giovi321/led-display/docs/src/content/docs/architecture/index.md

---
title: Architecture
description: How the firmware is put together
sidebar:
  hidden: true
---

How the firmware is put together:

- [Firmware modules](firmware/): boot order, module map, web asset pipeline, partitions
- [Pixel mapping](pixel-mapping/): the engine that turns logical coordinates into strip indices
- [Power](power/): measured consumption and the USB-C budget
