giovi321/led-display/docs/src/content/docs/index.mdx

---
title: LED Display
description: ESP32-S3 firmware for a wall display built from daisy-chained WS2812B matrix panels, with a web UI, an HTTP API, and a graphical panel arrangement editor
template: splash
hero:
  tagline: Firmware for a wall display built from daisy-chained WS2812B matrix panels and an ESP32-S3. Push one number or a short message to it over HTTP and it stays on the wall.
  actions:
    - text: Get started
      link: /led-display/getting-started/overview/
      icon: right-arrow
      variant: primary
    - text: View on GitHub
      link: https://github.com/giovi321/led-display
      icon: external
      variant: minimal
---

import { Card, CardGrid } from '@astrojs/starlight/components';
import displayRender from '../../assets/display-render.svg';

The reference build: four WS2812B 32x8 panels behind a smoked grey plexiglass front showing 1234, with a section through the layer stack

## What it does

The firmware drives a chain of WS2812B matrix panels as one logical display. It shows a single value or short message, posted to it over plain HTTP: a revenue figure, a temperature, whatever your automation sends. You describe how the panels physically hang on the wall (grid shape, chain order, rotation, wiring) in a graphical editor, and the firmware rebuilds its pixel mapping live, so changing the hardware never means recompiling.

<CardGrid stagger>
  <Card title="Set it up" icon="rocket">
    Pick the parts, build the panel sandwich, wire the level shifter, flash the firmware over USB once, and put the display on your WiFi. Start with the [overview](getting-started/overview/), then follow [hardware](getting-started/hardware/), [assembly](getting-started/assembly/), [first flash](getting-started/first-flash/), and [WiFi setup](getting-started/wifi-setup/).
  </Card>
  <Card title="Daily use" icon="setting">
    Everything routine happens in the built-in web UI: text, saved colours, brightness, three fonts at the sizes that fit, scroll modes, a weekly off or dim schedule, and the arrangement editor for the panel layout. See the [user guide](user-guide/).
  </Card>
  <Card title="Integrations" icon="puzzle">
    The device can fetch a value from a URL, or take a pushed one, and the display formats and shows it, with a fallback for feeds that break. There is also an MQTT client with Home Assistant discovery, an optional API key and web UI login, outbound webhooks, OTA updates, config backup, and a WireGuard client. See the [API reference](api-reference/).
  </Card>
</CardGrid>
