giovi321/led-display/docs/src/content/docs/development/index.md

---
title: Development
description: Building, testing, contributing, and cutting a release
sidebar:
  hidden: true
---

- [Building](building/): ESP-IDF setup, the WSL helper, host tests, web asset workflow
- [Contributing notes](contributing-notes/): repo layout, code style, what to touch when adding an endpoint
- [Releasing](releasing/): bump the version, tag, and let CI attach the binary devices update from
