giovi321/led-display/3D/8x32/Spacers.stl

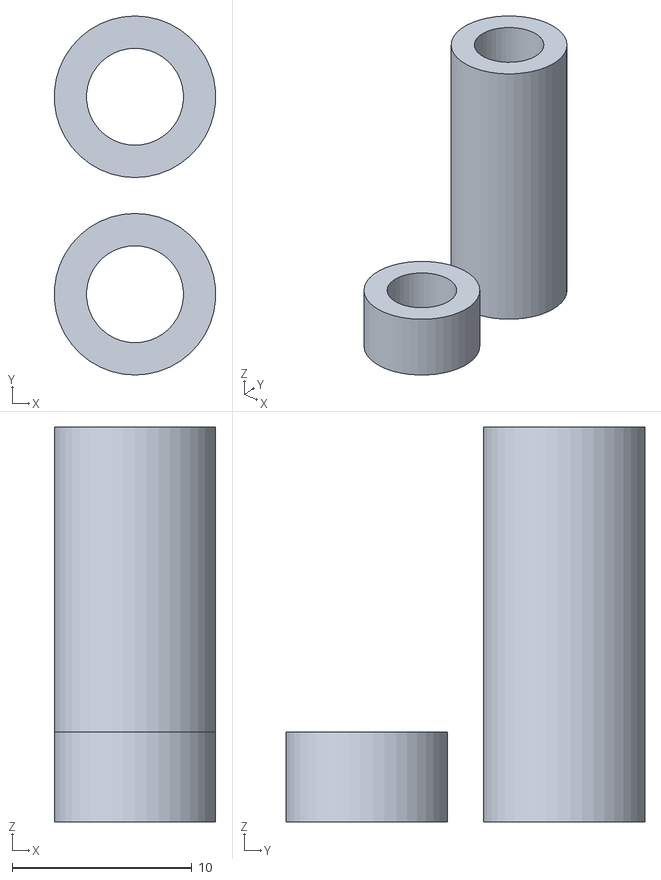
[picture p5: CAD file, 2026-08-14]
3D/8x32/Spacers.stl
8.97 x 20.0 x 22.0
