giovi321/led-display/3D/USB type c connector flange.stl

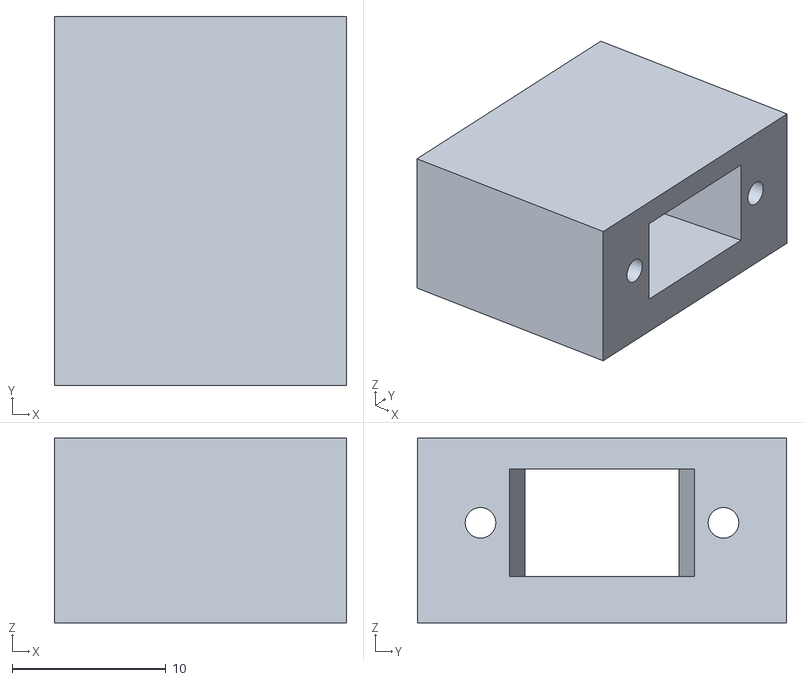
[picture p6: CAD file, 2026-08-14]
3D/USB type c connector flange.stl
19.0 x 24.0 x 12.0
