giovi321/led-display/3D/8x32/Display modules support panel.dxf

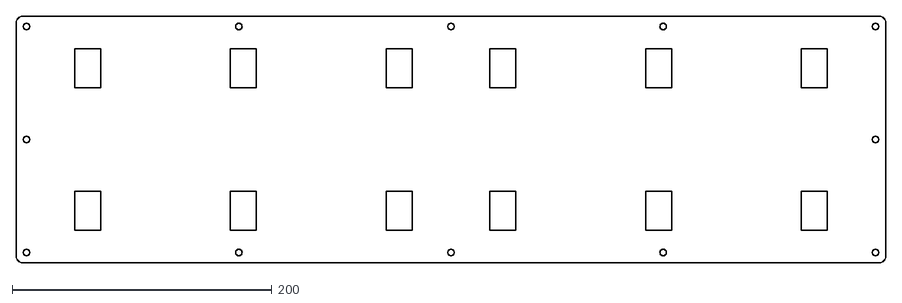
[picture p7: CAD file, 2026-08-14]
3D/8x32/Display modules support panel.dxf
670.0 x 190.0
