giovi321/led-display/3D/Box for PCB_v2.stl

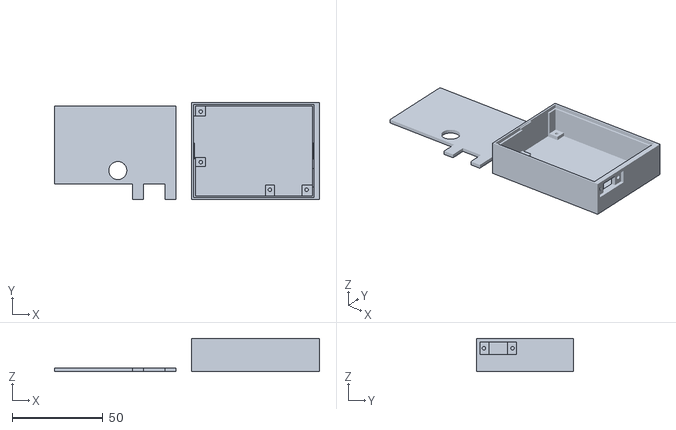
[picture p8: CAD file, 2026-08-14]
3D/Box for PCB_v2.stl
146.4 x 53.6 x 18.5
