giovi321/led-display/3D/8x32/Front and back panels.dxf

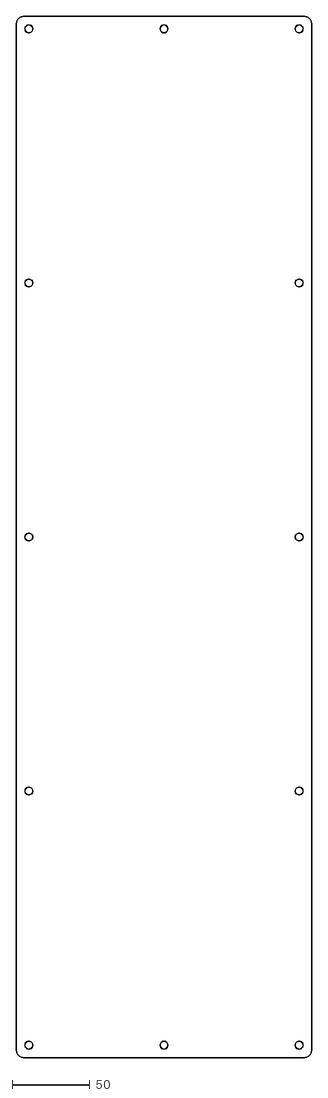
[picture p9: CAD file, 2026-08-14]
3D/8x32/Front and back panels.dxf
190.0 x 670.0
