giovi321/led-display/docs/src/content/docs/user-guide/index.md

---
title: User guide
description: "Daily use: text, colours, schedule, and value updates"
sidebar:
  hidden: true
---

The daily-use side of the web UI and API:

- [Display](display/): text, saved colours, brightness, scroll modes, fonts, size and spacing
- [Schedule](schedule/): switch the display off or dim it by weekday and time
- [Value updates](value-updates/): fetch a number from a URL or push it from n8n or any webhook source, with device-side formatting and a fallback
- [Screens](screens/): what the panel shows at power-on, once the network is up, and when the WiFi link drops
