giovi321/led-display/docs/src/content/docs/getting-started/index.md

---
title: Getting started
description: From parts to a display on your network
sidebar:
  hidden: true
---

From parts to a working display:

1. [Overview](overview/): what the firmware does and what is in the repository
2. [Hardware](hardware/): parts list, level shifter wiring, power budget
3. [Assembly](assembly/): build the reference display from the cut and printed parts
4. [First flash](first-flash/): build with ESP-IDF and flash over USB
5. [WiFi setup](wifi-setup/): join your network through the captive portal
