giovi321/led-display/(list of files, drawings)

Other design files:
PCB/RGB display_v4.fzz
