giovi321/led-display/Firmware/components/esp_wireguard/include/esp_wireguard.h

/*
 * Copyright (c) 2022 Tomoyuki Sakurai <y@trombik.org>
 * Copyright (c) 2023-2024 Simone Rossetto <simros85@gmail.com>
 * All rights reserved.
 *
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
 * 3. Neither the name of "Floorsense Ltd", "Agile Workspace Ltd" nor the names of
 *  its contributors may be used to endorse or promote products derived from this
 *   software without specific prior written permission.
 *
 * THIS SOFTWARE IS PROVIDED BY THE COPYRIGHT HOLDERS AND CONTRIBUTORS "AS IS" AND
 * ANY EXPRESS OR IMPLIED WARRANTIES, INCLUDING, BUT NOT LIMITED TO, THE IMPLIED
 * WARRANTIES OF MERCHANTABILITY AND FITNESS FOR A PARTICULAR PURPOSE ARE
 * DISCLAIMED. IN NO EVENT SHALL THE COPYRIGHT OWNER OR CONTRIBUTORS BE LIABLE FOR
 * ANY DIRECT, INDIRECT, INCIDENTAL, SPECIAL, EXEMPLARY, OR CONSEQUENTIAL DAMAGES
 * (INCLUDING, BUT NOT LIMITED TO, PROCUREMENT OF SUBSTITUTE GOODS OR SERVICES;
 * LOSS OF USE, DATA, OR PROFITS; OR BUSINESS INTERRUPTION) HOWEVER CAUSED AND ON
 * ANY THEORY OF LIABILITY, WHETHER IN CONTRACT, STRICT LIABILITY, OR TORT
 * (INCLUDING NEGLIGENCE OR OTHERWISE) ARISING IN ANY WAY OUT OF THE USE OF THIS
 * SOFTWARE, EVEN IF ADVISED OF THE POSSIBILITY OF SUCH DAMAGE.
 *
 */
#if !defined(__ESP_WIREGUARD__H__)
#define __ESP_WIREGUARD__H__

#ifdef __cplusplus
extern "C" {
#endif

/**
 * @brief Optional bring-up trace hook (local addition, see PORTING.md).
 *
 * The tunnel is brought up on the lwIP thread, so a fault inside the
 * component takes the whole device down with nothing to show for it in any
 * API. When set, this is called at each step of init/connect with the step
 * number, letting the caller record how far it got in storage that survives
 * a panic reset. NULL (the default) compiles down to nothing measurable.
 */
typedef void (*esp_wireguard_trace_fn_t)(int step);
extern esp_wireguard_trace_fn_t esp_wireguard_trace;

#define ESP_WG_TRACE(step_) \
    do { if (esp_wireguard_trace) esp_wireguard_trace(step_); } while (0)

/* Step numbers, kept here so caller and component agree. */
#define ESP_WG_STEP_CONNECT_ENTER      30
#define ESP_WG_STEP_CONNECT_NETIF      31
#define ESP_WG_STEP_CONNECT_DNS        32
#define ESP_WG_STEP_CONNECT_PEERINIT   33
#define ESP_WG_STEP_CONNECT_ADDPEER    34
#define ESP_WG_STEP_CONNECT_DONE       35
#define ESP_WG_STEP_IFINIT_ENTER       40
#define ESP_WG_STEP_IFINIT_UNDERLYING  41
#define ESP_WG_STEP_IFINIT_WGINIT      42
#define ESP_WG_STEP_IFINIT_UDP         43
#define ESP_WG_STEP_IFINIT_DEVICE      44
#define ESP_WG_STEP_IFINIT_KEYS        45
#define ESP_WG_STEP_IFINIT_DONE        46

#include <stdint.h>
#include <time.h>
#include <lwip/netif.h>
#include "esp_wireguard_err.h"

#define ESP_WIREGUARD_CONFIG_DEFAULT() { \
    .private_key = NULL, \
    .listen_port = 0, \
    .fw_mark = 0, \
    .public_key = NULL, \
    .preshared_key = NULL, \
    .address = NULL, \
    .netmask = NULL, \
    .endpoint = NULL, \
    .endpoint_ip = IPADDR4_INIT(0), \
    .port = 51820, \
    .persistent_keepalive = 0, \
}

#define ESP_WIREGUARD_CONTEXT_DEFAULT() { \
    .config = NULL, \
    .netif = NULL, \
    .netif_default = NULL, \
}

typedef struct {
    /* interface config */
    const char* private_key;            /**< a base64 private key generated by wg genkey. Required. */
    uint16_t    listen_port;            /**< a 16-bit port for listening */
    uint32_t    fw_mark;                /**< a 32-bit fwmark for outgoing packets */
    /* peer config */
    const char* public_key;             /**< a base64 public key calculated by wg pubkey from a private key. Required. */
    const char* preshared_key;          /**< a base64 preshared key generated by wg genpsk. */
    const char* address;                /**< a local IP address. */
    const char* netmask;                /**< a subnet mask of the local IP address. */
    const char* endpoint;               /**< an endpoint IP address or hostname. */
    ip_addr_t   endpoint_ip;            /**< endpoint IP address (internal use, resolved through dns query) */
    uint16_t    port;                   /**< a port number of remote endpoint. Default is 51820. */
    uint16_t    persistent_keepalive;   /**< a seconds interval, between 1 and 65535 inclusive, of how often to send an
                                             authenticated empty packet to the peer for the purpose of keeping a stateful
                                             firewall or NAT mapping valid persistently. Set zero to disable the feature.
                                             Default is zero. */
} wireguard_config_t;

typedef struct {
    wireguard_config_t* config;        /**< a pointer to wireguard config */
    struct netif*       netif;         /**< a pointer to configured netif */
    struct netif*       netif_default; /**< a pointer to the default netif. */
} wireguard_ctx_t;

/**
 * @brief Initialize WireGuard
 *
 * Call this function to initialize the context of WireGuard.
 *
 * Do not call this function multiple times.
 *
 * To connect to other peer, use `esp_wireguard_disconnect()`, and
 * `esp_wireguard_init()` with a new configuration. To reconnect to
 * the same peer just use `esp_wireguard_disconnect()` and then
 * `esp_wireguard_connect()`.
 *
 * @param       config WireGuard configuration.
 * @param[out]  ctx Context of WireGuard.
 *
 * @return
 *      - ESP_OK: Successfully initilized WireGuard interface.
 *      - ESP_ERR_INVALID_ARG: given argument is invalid.
 *      - ESP_ERR_INVALID_STATE: hostname dns resolution cannot start
 *      - ESP_FAIL: Other error.
 */
/**
 * @brief Derive the base64 public key from a base64 private key (local
 *        addition, see PORTING.md).
 *
 * Needed to configure the peer at the other end; the device has no other way
 * to report which key it is presenting. `out` needs room for 45 bytes.
 */
esp_err_t esp_wireguard_public_key(const char *private_key_b64, char *out, size_t outsz);

esp_err_t esp_wireguard_init(wireguard_config_t *config, wireguard_ctx_t *ctx);

/**
 * @brief Create a WireGuard interface and start establishing the connection
 *        to the peer.
 *
 * Call this function to start establishing the connection. Note that `ESP_OK`
 * does not mean the connection is established. To see if the connection is
 * established, or the peer is up, use `esp_wireguard_peer_is_up()`.
 *
 * Do not call this function multiple times.
 *
 * @param ctx Context of WireGuard.
 * @return
 *      - ESP_OK on success.
 *      - ESP_ERR_INVALID_ARG if input arguments are invalid
 *      - ESP_ERR_RETRY dns query still ongoing for endpoint hostname resolution (retry connection)
 *      - ESP_ERR_INVALID_IP if endpoint IP address is missing or invalid (dns query failed)
 *      - ESP_FAIL on failure.
 */
esp_err_t esp_wireguard_connect(wireguard_ctx_t *ctx);

/**
 * @brief Set the WireGuard network interface as the default.
 * @param ctx Context of WireGuard
 * @return
 *      - ESP_OK on success.
 *      - ESP_ERR_INVALID_ARG if ctx is NULL
 *      - ESP_ERR_INVALID_STATE if WireGuard interface is NULL
 */
esp_err_t esp_wireguard_set_default(const wireguard_ctx_t *ctx);

/**
 * @brief Restore the default network interface.
 * @param ctx Context of WireGuard
 * @return
 *      - ESP_OK on success.
 *      - ESP_ERR_INVALID_ARG if ctx is NULL
 *      - ESP_ERR_INVALID_STATE if the previous default interface is NULL
 */
esp_err_t esp_wireguard_restore_default(const wireguard_ctx_t *ctx);

/**
 * @brief Test if the peer is up.
 * @param ctx Context of WireGuard
 * @return
 *      - ESP_OK on peer up.
 *      - ESP_ERR_INVALID_ARG if ctx is NULL.
 *      - ESP_FAIL on peer still down.
 */
esp_err_t esp_wireguard_peer_is_up(const wireguard_ctx_t *ctx);
#define esp_wireguardif_peer_is_up(ctx) esp_wireguard_peer_is_up(ctx)  /**< backward compatibility with esp_wireguard before v0.4 */

/**
 * @brief Get timestamp of the latest handshake (with seconds resolution since unix epoch)
 * @param ctx Context of WireGuard
 * @param result the output timestamp
 * @return
 *      - ESP_OK on success
 *      - ESP_FAIL if no handshake already completed
 *      - ESP_ERR_INVALID_ARG if ctx is NULL
 *      - ESP_ERR_INVALID_STATE if data inside ctx is not valid
 */
esp_err_t esp_wireguard_latest_handshake(const wireguard_ctx_t *ctx, time_t *result);

/**
 * @brief Add new allowed IP/mask to the list of allowed ip/mask
 * @param ctx Context of WireGuard
 * @param allowed_ip The new IP to be allowed through tunnel
 * @param allowed_ip_mask The mask of the new IP
 * @return
 *      - ESP_OK on success
 *      - ESP_FAIL if the adding failed
 *      - ESP_ERR_INVALID_ARG if ctx, allowed_ip or allowed_ip_mask are invalid or empty
 *      - ESP_ERR_INVALID_STATE if data inside ctx is not valid
 */
esp_err_t esp_wireguard_add_allowed_ip(const wireguard_ctx_t *ctx, const char *allowed_ip, const char *allowed_ip_mask);

/**
 * @brief Disconnect from the peer
 *
 * @param ctx Context of WireGuard.
 * @return
 *      - ESP_OK on success.
 */
esp_err_t esp_wireguard_disconnect(wireguard_ctx_t *ctx);

#ifdef __cplusplus
}
#endif

#endif
// vim: expandtab tabstop=4
