giovi321/led-display/Firmware/main/api_colors.c

// /api/colors, /api/value and /api/value/config (see api_handlers.h for the
// ownership table, DESIGN.md section 5 for shapes).
//
// Saved colours are stored as one JSON blob ("colors" key,
// {"v":1,"colors":[{"name":"amber","r":80,"g":32,"b":0},...]}): POST
// replaces the whole list so the web UI never has to diff. /api/value is
// the generic inbound endpoint: whatever posts a number here (a webhook
// source, a home-automation flow, curl) gets it formatted through the
// value config and shown in the display's current colour, scrolling mode
// and speed.

#include <stdio.h>
#include <stdlib.h>
#include <string.h>

#include "cJSON.h"
#include "esp_log.h"

#include "api_handlers.h"
#include "display.h"
#include "integrations.h"
#include "settings.h"
#include "value_feed.h"
#include "valuefmt.h"
#include "web_common.h"

static const char *TAG = "api_colors";

#define COLORS_BLOB_KEY  "colors"
#define COLORS_MAX       12
#define COLOR_NAME_MAX   24

// ---- /api/colors -----------------------------------------------------------

static esp_err_t colors_get(httpd_req_t *req)
{
    cJSON *arr = NULL;

    char *buf = malloc(SETTINGS_BLOB_MAX);
    if (buf && settings_load_blob(COLORS_BLOB_KEY, buf, SETTINGS_BLOB_MAX,
                                  NULL) == ESP_OK) {
        cJSON *blob = cJSON_Parse(buf);
        if (blob) {
            cJSON *colors = cJSON_DetachItemFromObject(blob, "colors");
            if (cJSON_IsArray(colors)) {
                arr = colors;
            } else {
                cJSON_Delete(colors);
            }
            cJSON_Delete(blob);
        }
    }
    free(buf);

    cJSON *resp = cJSON_CreateObject();
    cJSON_AddItemToObject(resp, "colors", arr ? arr : cJSON_CreateArray());
    return web_send_json(req, resp);
}

// Validate a client-supplied colour list and rebuild it as the canonical
// blob (dropping any extra fields). Returns NULL when invalid.
static cJSON *colors_canonical(const cJSON *colors)
{
    if (!cJSON_IsArray(colors)) return NULL;
    if (cJSON_GetArraySize(colors) > COLORS_MAX) return NULL;

    cJSON *out = cJSON_CreateArray();
    const cJSON *it;
    cJSON_ArrayForEach(it, colors) {
        const cJSON *name = cJSON_GetObjectItem(it, "name");
        const cJSON *r    = cJSON_GetObjectItem(it, "r");
        const cJSON *g    = cJSON_GetObjectItem(it, "g");
        const cJSON *b    = cJSON_GetObjectItem(it, "b");
        if (!cJSON_IsString(name) || name->valuestring[0] == '\0' ||
            strlen(name->valuestring) > COLOR_NAME_MAX ||
            !cJSON_IsNumber(r) || r->valueint < 0 || r->valueint > 255 ||
            !cJSON_IsNumber(g) || g->valueint < 0 || g->valueint > 255 ||
            !cJSON_IsNumber(b) || b->valueint < 0 || b->valueint > 255) {
            cJSON_Delete(out);
            return NULL;
        }
        cJSON *entry = cJSON_CreateObject();
        cJSON_AddStringToObject(entry, "name", name->valuestring);
        cJSON_AddNumberToObject(entry, "r", r->valueint);
        cJSON_AddNumberToObject(entry, "g", g->valueint);
        cJSON_AddNumberToObject(entry, "b", b->valueint);
        cJSON_AddItemToArray(out, entry);
    }
    return out;
}

static esp_err_t colors_post(httpd_req_t *req)
{
    if (web_require_auth(req) != ESP_OK) return ESP_OK;

    cJSON *body = web_read_json(req, SETTINGS_BLOB_MAX);
    if (!body) return web_send_err(req, "invalid JSON body", 400);

    cJSON *canonical = colors_canonical(cJSON_GetObjectItem(body, "colors"));
    cJSON_Delete(body);
    if (!canonical) {
        return web_send_err(req,
                            "colors must be <=12 entries of "
                            "{name<=24ch,r,g,b 0..255}", 400);
    }

    cJSON *blob = cJSON_CreateObject();
    cJSON_AddNumberToObject(blob, "v", 1);
    cJSON_AddItemToObject(blob, "colors", canonical);
    char *json = cJSON_PrintUnformatted(blob);
    cJSON_Delete(blob);
    if (!json) return web_send_err(req, "out of memory", 500);

    esp_err_t err = settings_save_blob(COLORS_BLOB_KEY, json);
    cJSON_free(json);
    if (err != ESP_OK) {
        ESP_LOGE(TAG, "saving colors blob failed: %s", esp_err_to_name(err));
        return web_send_err(req, "saving colors failed", 500);
    }
    return web_send_ok(req);
}

// ---- /api/value ------------------------------------------------------------

static esp_err_t value_post(httpd_req_t *req)
{
    if (web_require_auth(req) != ESP_OK) return ESP_OK;

    cJSON *body = web_read_json(req, 512);
    if (!body) return web_send_err(req, "invalid JSON body", 400);

    const cJSON *val = cJSON_GetObjectItem(body, "value");
    char raw[DISPLAY_TEXT_MAX];
    if (cJSON_IsNumber(val)) {
        // Normalise JSON numbers so 4.2 and "4.2" behave the same; %.15g
        // keeps 15 significant digits without trailing-zero noise.
        snprintf(raw, sizeof(raw), "%.15g", val->valuedouble);
    } else if (cJSON_IsString(val)) {
        snprintf(raw, sizeof(raw), "%s", val->valuestring);
    } else {
        cJSON_Delete(body);
        return web_send_err(req, "body must be {\"value\":<string|number>}", 400);
    }
    cJSON_Delete(body);

    // Formats, remembers, counts as fresh and clears the fallback whatever
    // the display source; renders only while the source is "integration".
    char text[DISPLAY_TEXT_MAX];
    value_feed_ingest(raw, VALUE_SRC_HTTP, text, sizeof(text));

    settings_t cfg;
    settings_load(&cfg);
    bool rendered = (cfg.source == DISPLAY_SRC_INTEGRATION);

    cJSON *resp = cJSON_CreateObject();
    cJSON_AddBoolToObject(resp, "ok", true);
    cJSON_AddStringToObject(resp, "displayed", text);
    cJSON_AddBoolToObject(resp, "rendered", rendered);
    return web_send_json(req, resp);
}

// ---- /api/value/config -----------------------------------------------------

static esp_err_t value_cfg_get(httpd_req_t *req)
{
    value_cfg_t v;
    integrations_get_value_cfg(&v);

    // Every current key, plus the pre-2.12 stale_* / default_text keys
    // derived from the fallback config so old scripts still read something.
    cJSON *r = cJSON_CreateObject();
    integrations_value_cfg_to_json(&v, r, true);
    return web_send_json(req, r);
}

static esp_err_t value_cfg_post(httpd_req_t *req)
{
    if (web_require_auth(req) != ESP_OK) return ESP_OK;

    cJSON *body = web_read_json(req, 2048);
    if (!body) return web_send_err(req, "invalid JSON body", 400);

    // Overlay present fields onto the current config so clients can PATCH
    // a single field without knowing the whole schema.
    value_cfg_t v;
    integrations_get_value_cfg(&v);
    const char *msg = NULL;
    bool ok = integrations_value_cfg_from_json(&v, body, true, &msg);
    cJSON_Delete(body);
    if (!ok) return web_send_err(req, msg ? msg : "invalid value config", 400);

    esp_err_t err = integrations_set_value_cfg(&v);
    if (err != ESP_OK) {
        ESP_LOGE(TAG, "saving value config failed: %s", esp_err_to_name(err));
        return web_send_err(req, "saving value config failed", 500);
    }
    // A changed fallback text or mode shows now, not at the next tick.
    value_feed_apply_panel();
    return web_send_ok(req);
}

// ---- /api/value/preview ----------------------------------------------------

// Dry run of the formatter: formats `raw` with the stored config overlaid by
// the optional `cfg` object (same keys and errors as the config POST).
// Nothing is displayed or stored.
static esp_err_t value_preview_post(httpd_req_t *req)
{
    if (web_require_auth(req) != ESP_OK) return ESP_OK;

    cJSON *body = web_read_json(req, 2048);
    if (!body) return web_send_err(req, "invalid JSON body", 400);

    const cJSON *rawj = cJSON_GetObjectItem(body, "raw");
    char raw[DISPLAY_TEXT_MAX];
    if (cJSON_IsNumber(rawj)) {
        // Same normalisation as /api/value.
        snprintf(raw, sizeof(raw), "%.15g", rawj->valuedouble);
    } else if (cJSON_IsString(rawj)) {
        snprintf(raw, sizeof(raw), "%s", rawj->valuestring);
    } else {
        cJSON_Delete(body);
        return web_send_err(req,
                            "body must be {\"raw\":<string|number>,\"cfg\":{...}}",
                            400);
    }

    value_cfg_t v;
    integrations_get_value_cfg(&v);
    const cJSON *cfg = cJSON_GetObjectItem(body, "cfg");
    if (cfg && !cJSON_IsNull(cfg)) {
        const char *msg = NULL;
        if (!integrations_value_cfg_from_json(&v, cfg, true, &msg)) {
            cJSON_Delete(body);
            return web_send_err(req, msg ? msg : "invalid value config", 400);
        }
    }
    cJSON_Delete(body);

    char text[DISPLAY_TEXT_MAX];
    valuefmt_format(&v, raw, text, sizeof(text));

    cJSON *resp = cJSON_CreateObject();
    cJSON_AddStringToObject(resp, "text", text);
    return web_send_json(req, resp);
}

// ---- registration ----------------------------------------------------------

void api_colors_register(httpd_handle_t srv)
{
    static const httpd_uri_t uris[] = {
        {.uri = "/api/colors",       .method = HTTP_GET,  .handler = colors_get},
        {.uri = "/api/colors",       .method = HTTP_POST, .handler = colors_post},
        {.uri = "/api/value",        .method = HTTP_POST, .handler = value_post},
        {.uri = "/api/value/config", .method = HTTP_GET,  .handler = value_cfg_get},
        {.uri = "/api/value/config", .method = HTTP_POST, .handler = value_cfg_post},
        {.uri = "/api/value/preview", .method = HTTP_POST, .handler = value_preview_post},
    };
    for (size_t i = 0; i < sizeof(uris) / sizeof(uris[0]); i++) {
        web_register_uri(srv, &uris[i]);
    }
}
