giovi321/led-display/Firmware/main/wg_client.c

// WireGuard client glue. The real implementation (behind
// CONFIG_LEDDISP_WIREGUARD) drives the vendored esp_wireguard component; the
// no-op branch below stays as the permanent fallback so callers never need
// #ifdefs.
//
// Blob shape (versioned for forward migration, DESIGN.md section 4):
//   "wg" {"v":1,"enabled":false,"private_key":"..","peer_public_key":"..",
//         "endpoint_host":"..","endpoint_port":51820,"address":"10.6.0.2/32",
//         "allowed_ips":"10.6.0.0/24","keepalive_s":25}

#include "wg_client.h"

#include <string.h>

#include "sdkconfig.h"

#if CONFIG_LEDDISP_WIREGUARD

#include <stdio.h>
#include <stdlib.h>
#include <time.h>

#include "cJSON.h"
#include "esp_attr.h"
#include "esp_log.h"
#include "esp_netif.h"
#include "esp_system.h"
#include "freertos/FreeRTOS.h"
#include "freertos/semphr.h"
#include "freertos/task.h"
#include "lwip/ip_addr.h"
#include "nvs.h"

#include "esp_wireguard.h"
#include "wireguardif.h"
#include "settings.h"

static const char *TAG = "wg";

#define BLOB_WG            "wg"
#define WG_TASK_STACK      4096
#define WG_TASK_PRIO       3            // below the display refresh, above idle
#define WG_BACKOFF_MIN_MS  5000
#define WG_BACKOFF_MAX_MS  60000
// Crash-loop guard: this many consecutive crash reboots (panic/WDT) with the
// tunnel enabled and the tunnel stays down until the config is re-saved. A
// tunnel bug must never brick the device out of its own web UI.
#define WG_CRASH_HOLD_AFTER 3
#define NVS_NS_WG           "wg"
#define NVS_KEY_CRASHES     "crashes"
// Handshake timestamps (tai64n) need real wall time or the peer rejects the
// initiation as a replay. 2020-01-01 as "clock looks synced" heuristic.
#define WG_TIME_SANE       1577836800
#define WG_TIME_WAIT_S     90
// No completed handshake for this long after connect -> tear down and redo
// init, which also re-resolves the endpoint hostname (DNS may have changed).
#define WG_STALL_S         180

static SemaphoreHandle_t s_lock;
static wg_config_t       s_cfg;                 // persisted config (RAM cache)
static TaskHandle_t      s_task;
static volatile bool     s_task_stop;
static bool              s_held;                // crash-loop guard tripped

// The component keeps the const char* pointers we hand it for the lifetime of
// the tunnel, so they must point at storage that survives until teardown:
// a dedicated "active" copy, only rewritten while the tunnel is down.
static wg_config_t       s_active;
static char              s_active_ip[WG_ADDR_MAX + 1];   // address, CIDR stripped
static char              s_active_mask[16];              // dotted netmask
static wireguard_config_t s_wg_cfg;
static wireguard_ctx_t    s_wg_ctx;
static bool               s_tunnel_up_attempted;   // netif exists (init+connect issued)

// Tolerate pre-init callers, same pattern as integrations.c.
static void lock(void)   { if (s_lock) xSemaphoreTake(s_lock, portMAX_DELAY); }
static void unlock(void) { if (s_lock) xSemaphoreGive(s_lock); }

// ---- config (de)serialisation -----------------------------------------------

static void cfg_defaults(wg_config_t *c)
{
    memset(c, 0, sizeof(*c));
    c->endpoint_port = 51820;
    c->keepalive_s   = 25;
}

static void json_get_str(const cJSON *root, const char *key,
                         char *dst, size_t dstsz)
{
    const cJSON *it = cJSON_GetObjectItem(root, key);
    if (cJSON_IsString(it)) snprintf(dst, dstsz, "%s", it->valuestring);
}

static void load_cfg(wg_config_t *out)
{
    cfg_defaults(out);

    char buf[SETTINGS_BLOB_MAX];
    if (settings_load_blob(BLOB_WG, buf, sizeof(buf), NULL) != ESP_OK) {
        return;   // never written: defaults (disabled)
    }
    cJSON *root = cJSON_Parse(buf);
    if (!root) {
        ESP_LOGW(TAG, "wg blob unparseable, using defaults");
        return;
    }

    const cJSON *en = cJSON_GetObjectItem(root, "enabled");
    if (cJSON_IsBool(en)) out->enabled = cJSON_IsTrue(en);

    json_get_str(root, "private_key",     out->private_key,     sizeof(out->private_key));
    json_get_str(root, "peer_public_key", out->peer_public_key, sizeof(out->peer_public_key));
    json_get_str(root, "endpoint_host",   out->endpoint_host,   sizeof(out->endpoint_host));
    json_get_str(root, "address",         out->address,         sizeof(out->address));
    json_get_str(root, "allowed_ips",     out->allowed_ips,     sizeof(out->allowed_ips));

    const cJSON *port = cJSON_GetObjectItem(root, "endpoint_port");
    if (cJSON_IsNumber(port) && port->valueint > 0 && port->valueint <= 0xFFFF) {
        out->endpoint_port = (uint16_t)port->valueint;
    }
    const cJSON *ka = cJSON_GetObjectItem(root, "keepalive_s");
    if (cJSON_IsNumber(ka) && ka->valueint >= 0 && ka->valueint <= 0xFFFF) {
        out->keepalive_s = (uint16_t)ka->valueint;
    }

    cJSON_Delete(root);
}

static esp_err_t save_cfg(const wg_config_t *in)
{
    cJSON *root = cJSON_CreateObject();
    if (!root) return ESP_ERR_NO_MEM;
    cJSON_AddNumberToObject(root, "v", 1);
    cJSON_AddBoolToObject(root, "enabled", in->enabled);
    cJSON_AddStringToObject(root, "private_key", in->private_key);
    cJSON_AddStringToObject(root, "peer_public_key", in->peer_public_key);
    cJSON_AddStringToObject(root, "endpoint_host", in->endpoint_host);
    cJSON_AddNumberToObject(root, "endpoint_port", in->endpoint_port);
    cJSON_AddStringToObject(root, "address", in->address);
    cJSON_AddStringToObject(root, "allowed_ips", in->allowed_ips);
    cJSON_AddNumberToObject(root, "keepalive_s", in->keepalive_s);

    char *json = cJSON_PrintUnformatted(root);
    cJSON_Delete(root);
    if (!json) return ESP_ERR_NO_MEM;

    esp_err_t err = settings_save_blob(BLOB_WG, json);
    cJSON_free(json);
    return err;
}

// ---- crash-loop guard ---------------------------------------------------------
//
// Counts consecutive crash reboots (panic / watchdog) that happened while the
// tunnel was enabled. Any clean boot (power-on, software reset, OTA restart)
// resets the count, as does the first completed handshake: only an enabled
// tunnel that keeps taking the device down trips the guard.

static uint8_t crash_count_load(void)
{
    nvs_handle_t h;
    uint8_t v = 0;
    if (nvs_open(NVS_NS_WG, NVS_READONLY, &h) != ESP_OK) return 0;
    (void)nvs_get_u8(h, NVS_KEY_CRASHES, &v);
    nvs_close(h);
    return v;
}

static void crash_count_store(uint8_t v)
{
    nvs_handle_t h;
    if (nvs_open(NVS_NS_WG, NVS_READWRITE, &h) != ESP_OK) return;
    if (nvs_set_u8(h, NVS_KEY_CRASHES, v) == ESP_OK) (void)nvs_commit(h);
    nvs_close(h);
}

static bool boot_was_crash(void)
{
    switch (esp_reset_reason()) {
        case ESP_RST_PANIC:
        case ESP_RST_INT_WDT:
        case ESP_RST_TASK_WDT:
        case ESP_RST_WDT:
            return true;
        default:
            return false;
    }
}

// ---- bring-up diagnostics -------------------------------------------------
//
// Everything the component does at bring-up runs on the shared lwIP thread
// (esp_netif_tcpip_exec below), and its rekey timer runs there too, so a
// stack overflow in the tunnel's crypto reboots the whole device leaving no
// trace in any API. Two breadcrumbs make that visible from /api/status:
//
//   - the smallest free lwIP stack ever measured, sampled ON that thread
//     right after each component call, so an overflow shows up as a number
//     approaching zero instead of a mystery reboot
//   - the bring-up step that was in flight when the last crash hit, kept in
//     RTC memory: it survives a panic reset (which is exactly the case we
//     need it for) and costs no flash writes on a device that may be
//     retrying every few seconds
//
// RTC_NOINIT_ATTR is deliberately not zero-initialised, hence the magic.

#define WG_RTC_MAGIC  0x57474254u   /* "WGBT" */

RTC_NOINIT_ATTR static uint32_t s_rtc_magic;
RTC_NOINIT_ATTR static uint32_t s_rtc_stage;
RTC_NOINIT_ATTR static uint32_t s_rtc_tcpip_free_min;   // bytes, 0 = unsampled

static uint8_t  s_last_crash_stage;
static uint32_t s_last_crash_tcpip_free;   // carried over from the crashed run
static uint32_t s_attempts;
static char     s_public_key[WG_KEY_MAX + 1];   // derived once per config

static void stage_set(wg_stage_t stage)
{
    s_rtc_magic = WG_RTC_MAGIC;
    s_rtc_stage = (uint32_t)stage;
}

// Called from the lwIP thread only. ESP-IDF reports the high-water mark in
// bytes (its StackType_t is a byte), so no word scaling here.
static void note_tcpip_stack(void)
{
    uint32_t freeb = (uint32_t)uxTaskGetStackHighWaterMark(NULL);
    if (s_rtc_tcpip_free_min == 0 || freeb < s_rtc_tcpip_free_min) {
        s_rtc_tcpip_free_min = freeb;
    }
}

// Derived once per config change rather than per status read: x25519 is not
// free, and the answer only changes when the private key does.
static void refresh_public_key(const wg_config_t *cfg)
{
    s_public_key[0] = '\0';
    if (!cfg->private_key[0]) return;
    if (esp_wireguard_public_key(cfg->private_key, s_public_key,
                                 sizeof(s_public_key)) != ESP_OK) {
        s_public_key[0] = '\0';
        ESP_LOGW(TAG, "private key is not valid base64; public key unavailable");
    }
}

// Finer-grained steps from inside the component (esp_wireguard.h). Recorded
// the same way, so a crash between two of our own stages still says exactly
// which component call it died in.
static void wg_trace(int step)
{
    s_rtc_magic = WG_RTC_MAGIC;
    s_rtc_stage = (uint32_t)step;
    note_tcpip_stack();
}

// ---- CIDR helpers ------------------------------------------------------------

// "10.6.0.12/32" -> ip "10.6.0.12", prefix 32. No suffix means /32: safest
// default, routes only the tunnel address itself.
static void split_cidr(const char *in, char *ip, size_t ipsz, int *prefix)
{
    *prefix = 32;
    snprintf(ip, ipsz, "%s", in);
    char *slash = strchr(ip, '/');
    if (slash) {
        *slash = '\0';
        int p = atoi(slash + 1);
        if (p >= 0 && p <= 32) *prefix = p;
    }
}

static bool ipv4_parse(const char *s, uint32_t *out)
{
    unsigned a, b, c, d;
    if (sscanf(s, "%u.%u.%u.%u", &a, &b, &c, &d) != 4) return false;
    if (a > 255 || b > 255 || c > 255 || d > 255) return false;
    *out = ((uint32_t)a << 24) | ((uint32_t)b << 16) | ((uint32_t)c << 8) | d;
    return true;
}

// Which prefix the tunnel interface should carry.
//
// lwIP has no routing table: it picks an interface by matching the
// destination against each interface's own subnet, then falls back to the
// default interface. A tunnel address written the usual WireGuard way,
// "10.6.0.2/32", therefore leaves the tunnel matching nothing at all - not
// even the peer that is meant to be on the other end of it - so replies to
// anything inside the tunnel go out over WiFi and vanish. The symptom is a
// tunnel that handshakes but cannot be pinged.
//
// So the interface takes the widest allowed-IPs range that contains its own
// address instead. That is the range the user already said belongs to the
// tunnel, which makes it the honest netmask for it. 0.0.0.0/0 is skipped
// here because full-tunnel is handled by making WireGuard the default
// interface, which is a different mechanism.
static int netif_prefix_for(const char *ip, const char *allowed, int fallback)
{
    uint32_t addr;
    if (!ipv4_parse(ip, &addr)) return fallback;

    char list[WG_ALLOWED_MAX + 1];
    snprintf(list, sizeof(list), "%s", allowed);

    int best = fallback;
    char *save = NULL;
    for (char *tok = strtok_r(list, ", ", &save); tok;
         tok = strtok_r(NULL, ", ", &save)) {
        char net[WG_ADDR_MAX + 1];
        int prefix;
        split_cidr(tok, net, sizeof(net), &prefix);
        if (prefix < 1 || prefix > 31) continue;

        uint32_t netaddr;
        if (!ipv4_parse(net, &netaddr)) continue;

        uint32_t mask = 0xFFFFFFFFu << (32 - prefix);
        if ((addr & mask) != (netaddr & mask)) continue;   // does not contain us
        if (prefix < best) best = prefix;
    }
    return best;
}

static void prefix_to_netmask(int prefix, char *out, size_t outsz)
{
    uint32_t mask = (prefix == 0) ? 0 : 0xFFFFFFFFu << (32 - prefix);
    snprintf(out, outsz, "%u.%u.%u.%u",
             (unsigned)(mask >> 24) & 0xFF, (unsigned)(mask >> 16) & 0xFF,
             (unsigned)(mask >> 8) & 0xFF, (unsigned)mask & 0xFF);
}

// ---- component calls, marshalled into the lwIP thread ------------------------
//
// esp_wireguard drives raw lwIP APIs (netif_add, dns_gethostbyname, udp_*)
// which are only thread-safe from the tcpip thread unless
// CONFIG_LWIP_TCPIP_CORE_LOCKING is on (it is off by default), so every
// component call goes through esp_netif_tcpip_exec().

static esp_err_t tcpip_wg_init(void *arg)
{
    (void)arg;
    esp_err_t err = esp_wireguard_init(&s_wg_cfg, &s_wg_ctx);
    note_tcpip_stack();
    return err;
}

static esp_err_t tcpip_wg_connect(void *arg)
{
    (void)arg;
    esp_err_t err = esp_wireguard_connect(&s_wg_ctx);
    note_tcpip_stack();
    return err;
}

static esp_err_t tcpip_wg_disconnect(void *arg)
{
    (void)arg;
    return esp_wireguard_disconnect(&s_wg_ctx);
}

static esp_err_t tcpip_wg_peer_up(void *arg)
{
    (void)arg;
    return esp_wireguard_peer_is_up(&s_wg_ctx);
}

static esp_err_t tcpip_wg_handshake(void *arg)
{
    return esp_wireguard_latest_handshake(&s_wg_ctx, (time_t *)arg);
}

// Read back how lwIP actually configured the tunnel interface. Runs on the
// lwIP thread because the netif list is only safe to walk there.
static esp_err_t tcpip_wg_netif_info(void *arg)
{
    wg_status_t *out = (wg_status_t *)arg;
    struct netif *n = s_wg_ctx.netif;
    if (!n) return ESP_ERR_INVALID_STATE;

    uint32_t ip   = lwip_ntohl(netif_ip4_addr(n)->addr);
    uint32_t mask = lwip_ntohl(netif_ip4_netmask(n)->addr);
    snprintf(out->netif_ip, sizeof(out->netif_ip), "%u.%u.%u.%u",
             (unsigned)(ip >> 24) & 0xFF, (unsigned)(ip >> 16) & 0xFF,
             (unsigned)(ip >> 8) & 0xFF, (unsigned)ip & 0xFF);
    snprintf(out->netif_netmask, sizeof(out->netif_netmask), "%u.%u.%u.%u",
             (unsigned)(mask >> 24) & 0xFF, (unsigned)(mask >> 16) & 0xFF,
             (unsigned)(mask >> 8) & 0xFF, (unsigned)mask & 0xFF);
    out->netif_up      = netif_is_up(n);
    out->netif_link_up = netif_is_link_up(n);
    out->rx_accepted   = wireguardif_rx_accepted;
    out->rx_dropped    = wireguardif_rx_dropped;
    return ESP_OK;
}

typedef struct {
    const char *ip;
    const char *mask;
} allowed_ip_arg_t;

static esp_err_t tcpip_wg_allow(void *arg)
{
    const allowed_ip_arg_t *a = (const allowed_ip_arg_t *)arg;
    esp_err_t err = esp_wireguard_add_allowed_ip(&s_wg_ctx, a->ip, a->mask);
    note_tcpip_stack();
    return err;
}

static esp_err_t tcpip_wg_set_default(void *arg)
{
    (void)arg;
    return esp_wireguard_set_default(&s_wg_ctx);
}

// ---- tunnel lifecycle (caller holds s_lock) -----------------------------------

static void tunnel_teardown(void)
{
    if (!s_tunnel_up_attempted) return;
    // esp_wireguard_disconnect removes the peer and netif and restores the
    // previous default netif, giving us a clean slate for the next init.
    esp_err_t err = esp_netif_tcpip_exec(tcpip_wg_disconnect, NULL);
    if (err != ESP_OK) {
        ESP_LOGW(TAG, "teardown: %s", esp_err_to_name(err));
    }
    s_tunnel_up_attempted = false;
}

// Fill the component config from s_active. Strings passed to the component
// must stay valid for the tunnel lifetime, hence the static buffers.
static esp_err_t tunnel_start(void)
{
    int prefix;
    split_cidr(s_active.address, s_active_ip, sizeof(s_active_ip), &prefix);
    prefix = netif_prefix_for(s_active_ip, s_active.allowed_ips, prefix);
    prefix_to_netmask(prefix, s_active_mask, sizeof(s_active_mask));
    s_attempts++;

    wireguard_config_t cfg = ESP_WIREGUARD_CONFIG_DEFAULT();
    cfg.private_key          = s_active.private_key;
    cfg.public_key           = s_active.peer_public_key;
    cfg.address              = s_active_ip;
    cfg.netmask              = s_active_mask;
    cfg.endpoint             = s_active.endpoint_host;
    cfg.port                 = s_active.endpoint_port;
    cfg.persistent_keepalive = s_active.keepalive_s;
    s_wg_cfg = cfg;

    stage_set(WG_STAGE_INIT);
    esp_err_t err = esp_netif_tcpip_exec(tcpip_wg_init, NULL);
    if (err != ESP_OK) {
        stage_set(WG_STAGE_IDLE);
        return err;
    }

    stage_set(WG_STAGE_CONNECT);
    err = esp_netif_tcpip_exec(tcpip_wg_connect, NULL);
    // Once init/connect ran, a netif may exist even on failure; remember so
    // the next attempt starts from a teardown.
    s_tunnel_up_attempted = true;
    if (err != ESP_OK) stage_set(WG_STAGE_IDLE);
    return err;
}

// Route the configured allowed_ips (comma-separated CIDRs) through the
// tunnel. "0.0.0.0/0" additionally makes WireGuard the default interface.
static void tunnel_apply_allowed_ips(void)
{
    char list[WG_ALLOWED_MAX + 1];
    snprintf(list, sizeof(list), "%s", s_active.allowed_ips);

    char *save = NULL;
    for (char *tok = strtok_r(list, ", ", &save); tok;
         tok = strtok_r(NULL, ", ", &save)) {
        char ip[WG_ADDR_MAX + 1];
        char mask[16];
        int prefix;
        split_cidr(tok, ip, sizeof(ip), &prefix);
        prefix_to_netmask(prefix, mask, sizeof(mask));

        allowed_ip_arg_t arg = {.ip = ip, .mask = mask};
        esp_err_t err = esp_netif_tcpip_exec(tcpip_wg_allow, &arg);
        if (err != ESP_OK) {
            ESP_LOGW(TAG, "allowed_ip %s/%d: %s", ip, prefix,
                     esp_err_to_name(err));
        }
        if (prefix == 0) {
            // Full-tunnel config: everything should leave through WireGuard.
            (void)esp_netif_tcpip_exec(tcpip_wg_set_default, NULL);
        }
    }
}

// ---- retry/monitor task --------------------------------------------------------

// Sleep in short slices so wg_client_apply() can stop the task promptly even
// mid-backoff.
static bool task_sleep(uint32_t ms)
{
    while (ms > 0 && !s_task_stop) {
        uint32_t slice = ms > 250 ? 250 : ms;
        vTaskDelay(pdMS_TO_TICKS(slice));
        ms -= slice;
    }
    return !s_task_stop;
}

static void wg_task(void *arg)
{
    (void)arg;
    uint32_t backoff_ms = WG_BACKOFF_MIN_MS;

    // Handshake timestamps need wall time (SNTP runs elsewhere in boot).
    // Proceed after a grace period anyway: a peer that has never seen this
    // device accepts any initial timestamp.
    int waited = 0;
    while (!s_task_stop && time(NULL) < WG_TIME_SANE && waited < WG_TIME_WAIT_S) {
        vTaskDelay(pdMS_TO_TICKS(2000));
        waited += 2;
    }
    if (!s_task_stop && time(NULL) < WG_TIME_SANE) {
        ESP_LOGW(TAG, "time not synced after %ds, trying anyway", waited);
    }

    while (!s_task_stop) {
        lock();
        tunnel_teardown();
        esp_err_t err = tunnel_start();
        unlock();

        if (err != ESP_OK) {
            // Covers WiFi not up yet, DNS still resolving (ESP_ERR_RETRY)
            // and unreachable endpoints; all retried with backoff.
            ESP_LOGI(TAG, "connect: %s, retry in %us",
                     esp_err_to_name(err), (unsigned)(backoff_ms / 1000));
            if (!task_sleep(backoff_ms)) break;
            backoff_ms = backoff_ms * 2 > WG_BACKOFF_MAX_MS ? WG_BACKOFF_MAX_MS
                                                            : backoff_ms * 2;
            continue;
        }

        stage_set(WG_STAGE_ALLOWED);
        lock();
        tunnel_apply_allowed_ips();
        unlock();
        stage_set(WG_STAGE_MONITOR);
        backoff_ms = WG_BACKOFF_MIN_MS;

        // Monitor: the component's own timers handle rekeying and handshake
        // retries; we only watch for a long stall (endpoint moved, WiFi died)
        // and then rebuild the tunnel, which re-resolves the hostname.
        int down_s = 0;
        bool was_up = false;
        while (!s_task_stop) {
            if (!task_sleep(10000)) break;
            lock();
            bool up = esp_netif_tcpip_exec(tcpip_wg_peer_up, NULL) == ESP_OK;
            unlock();
            if (up) {
                if (!was_up) {
                    ESP_LOGI(TAG, "peer up");
                    // A working handshake proves the tunnel is healthy;
                    // forget any crash streak (single NVS write, on the
                    // transition only).
                    if (crash_count_load() != 0) crash_count_store(0);
                }
                was_up = true;
                down_s = 0;
            } else {
                down_s += 10;
                if (down_s >= WG_STALL_S) {
                    ESP_LOGW(TAG, "no handshake for %ds, rebuilding tunnel",
                             down_s);
                    break;   // outer loop tears down and reconnects
                }
            }
        }
    }

    lock();
    tunnel_teardown();
    unlock();
    stage_set(WG_STAGE_IDLE);
    s_task = NULL;
    vTaskDelete(NULL);
}

// Caller must NOT hold s_lock (the task takes it on its way out).
static void task_stop(void)
{
    s_task_stop = true;
    // The task polls the flag at least every 250 ms; 5 s covers a slow
    // teardown before we give up and log.
    for (int i = 0; i < 500 && s_task; i++) {
        vTaskDelay(pdMS_TO_TICKS(10));
    }
    if (s_task) {
        ESP_LOGE(TAG, "task did not stop, tunnel state may be inconsistent");
    }
    s_task_stop = false;
}

static esp_err_t task_start(void)
{
    if (s_task) return ESP_OK;
    s_task_stop = false;
    if (xTaskCreate(wg_task, "wg", WG_TASK_STACK, NULL, WG_TASK_PRIO,
                    &s_task) != pdPASS) {
        s_task = NULL;
        return ESP_ERR_NO_MEM;
    }
    return ESP_OK;
}

// ---- public API ----------------------------------------------------------------

esp_err_t wg_client_init(void)
{
    if (!s_lock) {
        s_lock = xSemaphoreCreateMutex();
        if (!s_lock) return ESP_ERR_NO_MEM;
    }

    // Read the breadcrumb before anything overwrites it. RTC memory survives
    // a panic reset but holds garbage after a power-on, hence the magic.
    bool was_crash = boot_was_crash();
    if (s_rtc_magic == WG_RTC_MAGIC && was_crash) {
        s_last_crash_stage      = (uint8_t)s_rtc_stage;
        s_last_crash_tcpip_free = s_rtc_tcpip_free_min;
    }
    stage_set(WG_STAGE_IDLE);
    s_rtc_tcpip_free_min = 0;   // start this run's measurement clean

    esp_wireguard_trace = wg_trace;

    wg_config_t cfg;
    load_cfg(&cfg);

    lock();
    s_cfg    = cfg;
    s_active = cfg;
    unlock();
    refresh_public_key(&cfg);

    // Keys never appear in logs (DESIGN.md section 10); the endpoint host is
    // fine, the component logs it during connect anyway.
    ESP_LOGI(TAG, "init: enabled=%d endpoint=%s:%u keepalive=%us keys=%s",
             cfg.enabled, cfg.endpoint_host[0] ? cfg.endpoint_host : "(unset)",
             (unsigned)cfg.endpoint_port, (unsigned)cfg.keepalive_s,
             cfg.private_key[0] ? "[redacted]" : "(unset)");

    if (cfg.enabled) {
        uint8_t crashes = crash_count_load();
        if (was_crash) {
            if (crashes < 0xFF) crashes++;
            crash_count_store(crashes);
            ESP_LOGW(TAG, "crash reboot with tunnel enabled (%u consecutive, "
                          "stage %u)",
                     (unsigned)crashes, (unsigned)s_last_crash_stage);
        } else if (crashes != 0) {
            crashes = 0;
            crash_count_store(0);
        }
        if (crashes >= WG_CRASH_HOLD_AFTER) {
            s_held = true;
            ESP_LOGE(TAG, "%u consecutive crash reboots; holding the tunnel "
                          "down (re-save the WireGuard config to retry)",
                     (unsigned)crashes);
            return ESP_OK;
        }
        return task_start();   // connects in the background, never blocks boot
    }
    return ESP_OK;
}

esp_err_t wg_client_apply(const wg_config_t *cfg)
{
    if (!cfg) return ESP_ERR_INVALID_ARG;

    // Defensive copy that guarantees NUL termination whatever the HTTP
    // handler stuffed into the fixed arrays.
    wg_config_t c = *cfg;
    c.private_key[WG_KEY_MAX]       = '\0';
    c.peer_public_key[WG_KEY_MAX]   = '\0';
    c.endpoint_host[WG_HOST_MAX]    = '\0';
    c.address[WG_ADDR_MAX]          = '\0';
    c.allowed_ips[WG_ALLOWED_MAX]   = '\0';

    if (c.enabled) {
        if (!c.private_key[0] || !c.peer_public_key[0] ||
            !c.endpoint_host[0] || !c.address[0] || c.endpoint_port == 0) {
            return ESP_ERR_INVALID_ARG;
        }
    }

    esp_err_t err = save_cfg(&c);
    if (err != ESP_OK) return err;

    // Stop the worker before swapping the active config: the component holds
    // pointers into s_active while the tunnel exists.
    task_stop();

    lock();
    tunnel_teardown();
    s_cfg    = c;
    s_active = c;
    unlock();
    refresh_public_key(&c);

    ESP_LOGI(TAG, "apply: enabled=%d endpoint=%s:%u", c.enabled,
             c.endpoint_host[0] ? c.endpoint_host : "(unset)",
             (unsigned)c.endpoint_port);

    // A deliberate re-save is the operator saying "try again": lift the
    // crash-loop hold and forget the streak.
    if (s_held || crash_count_load() != 0) {
        s_held = false;
        crash_count_store(0);
    }

    if (c.enabled) {
        return task_start();
    }
    return ESP_OK;
}

void wg_client_get_config(wg_config_t *out)
{
    if (!out) return;
    lock();
    *out = s_cfg;   // includes the private key; the export endpoint is gated
    unlock();
}

void wg_client_get_status(wg_status_t *out)
{
    if (!out) return;
    memset(out, 0, sizeof(*out));
    out->compiled_in = true;

    out->last_crash_stage      = s_last_crash_stage;
    out->last_crash_tcpip_free = s_last_crash_tcpip_free;
    out->tcpip_stack_free_min  = s_rtc_tcpip_free_min;
    out->attempts              = s_attempts;
    out->stage                 = (uint8_t)s_rtc_stage;
    snprintf(out->public_key, sizeof(out->public_key), "%s", s_public_key);
    // Filled in by the component's DNS callback; zero until it resolves, so
    // a blank here means the endpoint hostname never came back.
    if (s_tunnel_up_attempted) {
        uint32_t a = lwip_ntohl(ip_2_ip4(&s_wg_cfg.endpoint_ip)->addr);
        snprintf(out->endpoint_ip, sizeof(out->endpoint_ip), "%u.%u.%u.%u",
                 (unsigned)(a >> 24) & 0xFF, (unsigned)(a >> 16) & 0xFF,
                 (unsigned)(a >> 8) & 0xFF, (unsigned)a & 0xFF);
    }

    lock();
    out->enabled = s_cfg.enabled;
    out->held    = s_held;
    if (s_tunnel_up_attempted) {
        out->up = esp_netif_tcpip_exec(tcpip_wg_peer_up, NULL) == ESP_OK;
        time_t hs = 0;
        if (esp_netif_tcpip_exec(tcpip_wg_handshake, &hs) == ESP_OK) {
            out->last_handshake = (int64_t)hs;
        }
        (void)esp_netif_tcpip_exec(tcpip_wg_netif_info, out);
    }
    unlock();
}

#else  // !CONFIG_LEDDISP_WIREGUARD

esp_err_t wg_client_init(void)
{
    return ESP_OK;
}

esp_err_t wg_client_apply(const wg_config_t *cfg)
{
    (void)cfg;
    return ESP_ERR_NOT_SUPPORTED;
}

void wg_client_get_config(wg_config_t *out)
{
    if (out) memset(out, 0, sizeof(*out));
}

void wg_client_get_status(wg_status_t *out)
{
    if (!out) return;
    memset(out, 0, sizeof(*out));
    out->compiled_in = false;
}

#endif  // CONFIG_LEDDISP_WIREGUARD
