giovi321/led-display/Firmware/components/esp_wireguard/src/wireguard.h

/*
 * Copyright (c) 2021 Daniel Hope (www.floorsense.nz)
 * All rights reserved.
 *
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
 * 3. Neither the name of "Floorsense Ltd", "Agile Workspace Ltd" nor the names of
 *  its contributors may be used to endorse or promote products derived from this
 *   software without specific prior written permission.
 *
 * THIS SOFTWARE IS PROVIDED BY THE COPYRIGHT HOLDERS AND CONTRIBUTORS "AS IS" AND
 * ANY EXPRESS OR IMPLIED WARRANTIES, INCLUDING, BUT NOT LIMITED TO, THE IMPLIED
 * WARRANTIES OF MERCHANTABILITY AND FITNESS FOR A PARTICULAR PURPOSE ARE
 * DISCLAIMED. IN NO EVENT SHALL THE COPYRIGHT OWNER OR CONTRIBUTORS BE LIABLE FOR
 * ANY DIRECT, INDIRECT, INCIDENTAL, SPECIAL, EXEMPLARY, OR CONSEQUENTIAL DAMAGES
 * (INCLUDING, BUT NOT LIMITED TO, PROCUREMENT OF SUBSTITUTE GOODS OR SERVICES;
 * LOSS OF USE, DATA, OR PROFITS; OR BUSINESS INTERRUPTION) HOWEVER CAUSED AND ON
 * ANY THEORY OF LIABILITY, WHETHER IN CONTRACT, STRICT LIABILITY, OR TORT
 * (INCLUDING NEGLIGENCE OR OTHERWISE) ARISING IN ANY WAY OUT OF THE USE OF THIS
 * SOFTWARE, EVEN IF ADVISED OF THE POSSIBILITY OF SUCH DAMAGE.
 *
 * Author: Daniel Hope <daniel.hope@smartalock.com>
 */

#ifndef _WIREGUARD_H_
#define _WIREGUARD_H_

#ifdef __cplusplus
extern "C" {
#endif


#include <stdint.h>
#include <stdlib.h>
#include <stdbool.h>

// Note: these are only required for definitions in device/peer for netif, udp_pcb, ip_addr_t and u16_t
#include "lwip/netif.h"
#include "lwip/udp.h"
#include "lwip/ip_addr.h"
#include "lwip/arch.h"

// Platform-specific functions that need to be implemented per-platform
#include "wireguard-platform.h"

// tai64n contains 64-bit seconds and 32-bit nano offset (12 bytes)
#define WIREGUARD_TAI64N_LEN		(12)
// Auth algorithm is chacha20pol1305 which is 128bit (16 byte) authenticator
#define WIREGUARD_AUTHTAG_LEN		(16)
// Hash algorithm is blake2s which makes 32 byte hashes
#define WIREGUARD_HASH_LEN			(32)
// Public key algo is curve22519 which uses 32 byte keys
#define WIREGUARD_PUBLIC_KEY_LEN	(32)
// Public key algo is curve22519 which uses 32 byte keys
#define WIREGUARD_PRIVATE_KEY_LEN	(32)
// Symmetric session keys are chacha20/poly1305 which uses 32 byte keys
#define WIREGUARD_SESSION_KEY_LEN	(32)

// Timers / Limits
#define WIREGUARD_COOKIE_LEN		(16)
#define COOKIE_SECRET_MAX_AGE		(2 * 60)
#define COOKIE_NONCE_LEN			(24)

#define REKEY_AFTER_MESSAGES		(1ULL << 60)
#define REJECT_AFTER_MESSAGES		(0xFFFFFFFFFFFFFFFFULL - (1ULL << 13))
#define REKEY_AFTER_TIME			(120)
#define REJECT_AFTER_TIME			(180)
#define REKEY_TIMEOUT				(5)

struct wireguard_keypair {
	bool valid;
	bool initiator; // Did we initiate this session (send the initiation packet rather than sending the response packet)
	uint32_t keypair_millis;

	uint8_t sending_key[WIREGUARD_SESSION_KEY_LEN];
	bool sending_valid;
	uint64_t sending_counter;

	uint8_t receiving_key[WIREGUARD_SESSION_KEY_LEN];
	bool receiving_valid;

	uint32_t last_tx;
	uint32_t last_rx;

	uint32_t replay_bitmap;
	uint64_t replay_counter;

	uint32_t local_index; // This is the index we generated for our end
	uint32_t remote_index; // This is the index on the other end
};

struct wireguard_handshake {
	bool valid;
	bool initiator;
	uint32_t local_index;
	uint32_t remote_index;
	uint8_t ephemeral_private[WIREGUARD_PRIVATE_KEY_LEN];
	uint8_t remote_ephemeral[WIREGUARD_PUBLIC_KEY_LEN];
	uint8_t hash[WIREGUARD_HASH_LEN];
	uint8_t chaining_key[WIREGUARD_HASH_LEN];
};

struct wireguard_allowed_ip {
	bool valid;
	ip_addr_t ip;
	ip_addr_t mask;
};
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
