giovi321/led-display/(commit log)

2026-08-14 led-display 2.1.0
    ESP-IDF firmware for chained WS2812B matrix panels on ESP32-S3: web UI with
    a graphical panel-arrangement editor and identify mode, value API with
    device-side formatting and staleness guard, saved colours, weekly schedule,
    OTA updates (browser upload, URL pull, GitHub releases), config backup and
    restore, optional API key, outbound webhooks, optional WireGuard client,
    documentation site under docs/.
    [Display panel.skp, Display panel.stl, Display panel_base.dxf, Display panel_base.skp, Display panel_v4.dxf, PCB box.skp, PCB box.stl, PCB box_top-only.stl]
2026-08-14 Prepare repository for public release
    Reorganise 3D/ around panel size: the frame parts for a build from 32x8
    panels move under 3D/8x32/ (support panel and front/back panels as DXF,
    spacers as STL), the controller enclosure becomes Box for PCB_v2.stl, and
    the superseded PCB box and hooked spacers move to the ignored _old/.
    Stop tracking SketchUp sources. The .skp files stay on the modelling
    machine; the repo ships the STL and DXF exports that are useful without
    SketchUp. *.skp and .impeccable/ are now ignored.
    Remove docs.md. It described the v1 firmware (compile-time mapping enum,
    the old five-tab web UI) that 2.0.0 replaced, and the documentation site
    covers the same ground correctly und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
    [Box for PCB_v2.stl, Display modules support panel.dxf, Display panel.skp, Display panel.stl, Display panel_base.skp, Front and back panels.dxf, PCB box.skp, PCB box.stl]
2026-08-14 led-display 2.2.0
    Display: 3x5/5x7/7x12 fonts, proportional spacing with tabular digits,
    continuous scroll mode. Schedule: off-window dim action. Network: up to
    5 saved WiFi networks, runtime reconnect with AP+STA fallback, setup-AP
    banner on the panels, configurable device name (hostname, AP SSID,
    webhook identity). Hardware: optional ambient light sensor on an ADC1
    pin driving brightness through a calibrated curve. WireGuard compiled
    in by default. Hardened API auth (origin check, provisioning-only
    keyless WiFi), release and docs workflows, new assembly and releasing
    guides.
2026-08-14 led-display 2.3.0
    Fix the WireGuard reboot loop, add MQTT, and split the display between a
    static text and a live integration value.
    WireGuard: all tunnel crypto (psa_crypto_init, the x25519/blake2s
    handshakes, the component's rekey timer) runs on the lwIP tcpip task, and
    the 3072-byte default stack overflowed into a canary panic roughly 90
    seconds after every boot with the tunnel enabled, taking the device off the
    network with it. The stack is now sized for it. A crash-loop guard backs
    that up: three consecutive crash reboots with the tunnel enabled and it
    stays down at boot (reported as `held`) until the config is re-saved, so a
    future fault of this class cannot lock anyone out of the web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
    [api_colors.c, api_config.c, api_display.c, api_handlers.h, api_integrations.c, api_system.c, fw_version.h]
2026-08-15 led-display 2.3.1
    Fix the WireGuard crash for real, and switch timezones to IANA names.
    The tunnel never had a stack problem. ESP-IDF keeps its own per-interface
    handle in the lwIP netif's `state` field, and the global interface-event
    callback it installs casts that field back to an esp_netif handle without
    checking. WireGuard adds a raw lwIP interface whose `state` points at the
    component's own device structure, so the first address event during
    interface creation handed ESP-IDF a pointer to the wrong type, it
    dereferenced it, and the device panicked - before a single line of
    WireGuard's own setup ran. ESP-IDF states the rule in lwipopts.h, that
    interfaces using `state` themselves need the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
    [api_system.c, esp_wireguard.c, esp_wireguard.h, fw_version.h, main.c, scheduler.c, scheduler.h, test_tz.c]
2026-08-15 led-display 2.3.2
    Make a working tunnel actually reachable, and say why one that is not
    working is not working.
    A handshake was never going to be enough on its own. The tunnel address is
    normally written as a /32, the way wg-quick configurations do it, but this
    device has no routing table: lwIP picks an interface by matching the
    destination against that interface's own subnet, and otherwise falls back
    to the default one. Taken literally a /32 tunnel matches nothing at all,
    not even the peer at the far end, so replies to anything inside the tunnel
    left over WiFi and disappeared. The interface now takes the widest allowed
    IPs range that contains its own address, which is the range the user ha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
    [api_integrations.c, api_system.c, esp_wireguard.c, esp_wireguard.h, fw_version.h, wg_client.c, wg_client.h, wireguard.c]
2026-08-15 led-display 2.4.0
    Three things asked for after living with the tunnel for a day.
    The two WireGuard key fields both said "public key" and were easy to read
    as the same value. They belong to different keypairs pointing in opposite
    directions, so they now say which is which and where each one goes.
    VPN state joins WiFi in the header, with its own icon and the same three
    states: connecting, up with the tunnel address and handshake age, or
    suspended. It stays hidden entirely when the tunnel is off.
    What the display shows is now three separate decisions instead of one. At
    boot, the splash: the border test by default, because lighting every edge
    pixel is what makes a miswired panel obvious in th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
2026-08-15 led-display 2.4.1
    Stop leading the WireGuard card with this device's public key.
    It was there because configuring a peer by hand needs it, and because
    during debugging there was no way to tell which key the device was
    presenting. Neither is the common case. A server that generates the client
    configuration for you - UniFi, and most router and VPN provider interfaces
    - makes the keypair at its end, keeps the public half, and hands back a
    config containing the private key. Paste that in and the two sides already
    agree. A prominent field for a value you never have to touch only invites
    the question of what it is supposed to pair with, sitting next to a field
    named almost identically for the oth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
2026-08-15 led-display 2.5.0
    A batch of things that came out of living with the display.
    Every tab has an address now. Reload, bookmark and the back button all
    land where you were instead of on the Display tab, and a link into an
    advanced tab turns advanced mode on rather than quietly showing something
    else. The device serves the page for those paths too, registered one by
    one so nothing can shadow the API.
    Text can leave a trail. Each pixel keeps a percentage of its brightness
    into the next frame instead of going out at once, so a scrolling value
    drags a decaying smear behind it the way a slow phosphor does. Off by
    default and invisible on static text, which is drawn once and then left
    alone.
    A los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
2026-08-15 led-display 2.5.1
    Fix three range checks left behind when the screen options grew.
    Adding the single-pixel offline indicator and the ip-then-content boot
    screen extended two enums, but three bounds checks kept the old upper
    limit and quietly folded the new values back to zero. Picking the pixel
    indicator stored correctly and then reported itself as "keep the last
    content", so the web UI showed the wrong option and undid the choice on
    the next save; a stored ip-then-content boot screen would have been
    discarded on the next boot for the same reason.
    Caught by reading a setting back after writing it rather than trusting
    the write, which is worth doing for every option with a validated range.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
    [api_config.c, api_system.c, fw_version.h, settings.c]
2026-08-15 led-display 2.5.2
    Stop a blank WireGuard form from erasing a working tunnel.
    The card posts every field it has, so pressing Save before the page had
    loaded its values wrote empty strings over the endpoint, the address and
    the allowed IPs, leaving a tunnel that still had its private key and
    nothing to connect to. Observed on the bench, and the kind of thing that
    looks like the device losing its configuration by itself.
    Saving a form with no endpoint, address or peer key at all is now
    refused. Clearing the configuration on purpose is what Reset config is
    for, and the message says so.
    [fw_version.h]
2026-08-15 led-display 2.6.0
    Fix the schedule leaving the panel dark, and drop the scroll trail.
    Disabling the schedule from inside an off-window did nothing visible.
    The off-window flag is what the brightness arbiter reads, and only the
    30-second tick ever cleared it, so the panel stayed at zero until the
    tick came round; worse, brightness changes made in that gap were stored
    and then discarded on the way to the panel, which reads as the display
    ignoring you entirely. The window is now re-evaluated as soon as the
    schedule is saved, in both directions, so enabling one mid-window takes
    effect immediately too.
    The scroll trail from 2.5.0 is removed rather than fixed. It rendered
    badly, and a decorative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
    [api_config.c, api_display.c, api_system.c, display.c, display.h, fw_version.h, led_driver.c, led_driver.h]
2026-08-15 led-display 2.7.0
    Fix updating from GitHub, and make the offline pixel an overlay.
    Updating from a GitHub release always died at the download with
    "download failed to start: ESP_FAIL", while uploading the same .bin by
    hand worked. The asset URL is 80 characters, but GitHub answers it with
    a redirect to a signed URL whose query string alone runs to about 800
    bytes, and the HTTP client formats the whole request line into a
    transmit buffer sized for the 512-character URL the API accepts rather
    than for wherever that URL leads. Measured against the v2.6.0 asset the
    redirected request line is 880 bytes against 768 of buffer, so the
    client refuses it before a byte is fetched. It now gets 2 KB, wi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
    [api_config.c, api_system.c, display.c, display.h, fw_version.h, led_driver.c, led_driver.h, main.c]
2026-08-15 led-display 2.8.0
    Optional web UI login, a rule for unticked schedule days, and a favicon.
    The web UI can now ask for a username and password. It is off by
    default and stays off across an update, and when it is on it covers
    every URI the device serves - pages, assets and the whole API, the open
    GETs included - because a login that leaves the configuration readable
    is not one. The API key is untouched and still gates writes for
    scripts; the two compose. Enabling it without a stored password is a
    400 rather than a silent no-op, so a client that asked for a login and
    got ok can trust that it has one.
    Two limits are stated wherever the feature is described. It is HTTP
    Basic over plain HTTP, so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
2026-08-15 Docs: cover the unticked-day rule and the web UI login
    The schedule guide still said an unticked day always keeps the display
    off, which stopped being the whole truth in 2.8.0. It now explains both
    settings and why the default is the one that does not change behaviour
    on update.
    The admin index and the landing page still described the API key as the
    only lock, and the README's security section did not mention the login
    at all - including the two things worth knowing before turning it on,
    that it is Basic over plain HTTP and that the setup AP is exempt.
2026-08-15 led-display 2.8.1
    Move the Web UI login to the System tab.
    It governs the whole interface rather than one integration, so it sat
    oddly on the Integrations tab next to the webhook and MQTT cards. The
    card now loads its own state instead of riding on the Integrations
    refresh, so it populates whether you click through to /system or land
    there directly from a bookmark.
2026-08-15 Docs: describe the controller board, with renders from the Gerbers
    The PCB was a directory reference and nothing else: a reader could not
    learn its size, that it is two layers, that the ESP32 is socketed rather
    than soldered, or that the four PWR connectors exist. That last one
    matters most - the hardware guide already warns not to run panel current
    through the signal daisy-chain, without mentioning the board is laid out
    to solve exactly that.
    Every figure comes from the files rather than from the editor: the
    outline from the contour Gerber, the 90 holes and their six diameters
    from the drill file, the parts and the netlist from the Fritzing sketch.
    Where the files do not say, the docs say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
2026-08-15 Docs: add the board BOM and the netlist walkthrough
    The controller board section described the board but never listed what
    goes on it. The BOM covers all six board parts with footprints, and
    separates them from the parts that are in the top-of-page table but have
    no footprint here - the dev board, the USB-C breakout, the light sensor.
    The netlist walkthrough is read back out of the Fritzing sketch rather
    than from the schematic intent, which is worth having because it
    confirms the level-shifter wiring table describes the board that was
    actually built.
    The capacitor values stay marked as unspecified. They are blank in the
    design and cannot be recovered from it.
2026-08-15 led-display 2.9.0
    Support the BH1750 lux meter, and take the board to v4.
    The light sensor gains a second source. The analog input stays exactly
    as it was and remains a first-class option: it needs no extra module
    and works on a v3 board. Alongside it the firmware now reads a BH1750
    digital lux meter over I2C at 0x23, which the v4 board has a connector
    for.
    Only the read is different. Three small functions in light_sensor.c
    know which sensor is fitted; the curve, the smoothing, the hysteresis
    and the handover to the scheduler's brightness arbiter are shared, so
    one calibration flow serves both and lux simply arrives on the same
    0..4095 scale the ADC used. Switching source throws the smooth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
    [RGB display_v3.fzz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]
2026-08-15 led-display 2.10.0
    Drop the analog light sensor; the BH1750 is the only one.
    2.9.0 added the BH1750 alongside the ADC path and kept both. Keeping
    the one the board has no connector for was not worth the branch in
    every layer it touched, so it goes: the ADC reads, the type selector,
    the gpio field, valid_gpios, the pin validator and the UI row are all
    removed. light_sensor.c reads one sensor and no longer dispatches, and
    light_curve.c is down to the curve plus the I2C pin rules.
    A stored analog configuration is discarded rather than migrated. The
    sensor comes up switched off, so a device that had one hands the panel
    back to its saved brightness instead of sitting on a reading it cannot
    take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
    [api_config.c, api_display.c, fw_version.h, light_curve.c, light_curve.h, light_sensor.c, light_sensor.h, test_light_curve.c]
2026-08-15 Docs: clean up prose, correct stale facts, redraw the fixings
    Prose pass across the README, DESIGN.md, PCB/README.md and the whole
    Starlight site: replace the spaced-hyphen dashes with real punctuation,
    drop the mechanically bolded lead-ins from list items, and cut the
    version-by-version history that had accumulated in pages describing
    current behaviour. The analog light sensor is gone from the docs
    entirely; the BH1750 is simply the sensor. Its removal is still recorded
    in the CHANGELOG, which is where version history belongs.
    Correct several things the docs got wrong:
    - the boot order had WireGuard starting before the HTTP server. main.c
    starts it and MQTT after ota_mark_valid, which i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
2026-08-15 CI: move off the Node 20 action runtimes, bust the README image cache
    GitHub is force-running every pinned action on Node 24 and warning that
    the Node 20 targets are deprecated. Bump them to the current majors:
    checkout v4 to v7, setup-node v4 to v7, configure-pages v5 to v6,
    upload-pages-artifact v3 to v5, deploy-pages v4 to v5, and
    action-gh-release v2 to v3, whose 3.0.0 is the same runtime move and
    nothing else. esp-idf-ci-action is a composite action with no Node
    runtime of its own and stays on v1.
    Two behaviour changes came with those majors and both are harmless here.
    setup-node v5 caches automatically when `cache` is unset; this workflow
    sets it explicitly, so nothing changes. upload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
2026-08-15 README: restructure "What it does" around what the firmware actually does
    The section was eighteen flat bullets in no particular order, mixing a
    headline capability (the arrangement editor) with a one-line detail (the
    device name), and it listed the API key twice. Nothing told a reader
    which parts mattered.
    Group it into five, ordered the way you meet the device: get the panels
    behaving as one display, render a number that changes, feed it, leave it
    running, then operate it. Each heading states the claim its bullets
    support, so skimming the headings alone gives the shape of the firmware.
    Same coverage, minus the duplicate API key bullet. The web UI and the
    device name moved into the lead p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
2026-09-01 led-display 2.11.0
    Two ways the display could pull more current than the supply can give, and
    both of them ended with the resettable fuse cutting out and the panel going
    dark until someone unplugged it.
    Content-driven overdraw. A new pure module, power_model.[hc], prices a frame
    from the sum of its channel bytes: px * I_quiescent + (sum / 255) *
    I_channel_full. led_driver_refresh() runs a read-only summing pass before the
    write pass, so the estimate covers the pixels actually lit rather than the
    all-pixels-lit worst case, which at a normal operating point is five times too
    pessimistic to be believed. The brightness slider now shows what a setting
    will draw before it is applied, with the wor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
    [api_config.c, api_display.c, api_system.c, display.c, display.h, fw_version.h, led_driver.c, led_driver.h]
2026-10-28 Terminate jsonpath output on every failure path
    [jsonpath.c, test_jsonpath.c]
2026-10-28 led-display 2.12.0
2026-10-28 Fix final review findings in firmware
    [api_config.c, api_value_poll.c, main.c, mqtt_link.c, scheduler.c, value_feed.c, value_poll.c, webhooks.c]
2026-10-29 led-display 2.12.1
    Turn on cross-signed verification in the certificate bundle, so HTTPS hosts
    that send a cross-signed root as the last certificate (Google Trust Services)
    pass the handshake. A poll that cannot connect now says whether DNS, TCP or
    TLS failed. The custom header is the only auth option for the URL poll and
    the status webhook; the separate Bearer secret field is gone.
    [api_config.c, api_integrations.c, api_value_poll.c, fw_version.h, http_auth.h, integrations.c, integrations.h, value_poll.c]
